hengty/DAQ_prototype/IMG_20180813_171540.jpg

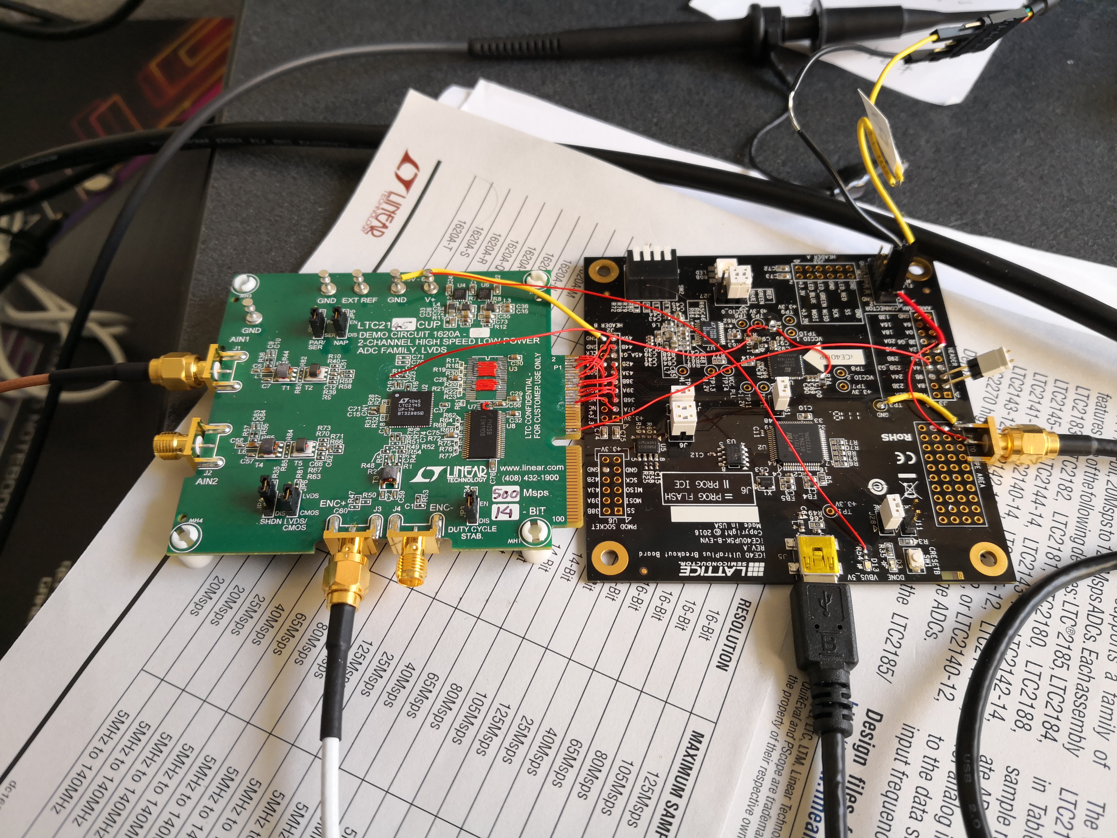
IMG_20180813_171540.jpg
