hengty/DAQ_prototype/A Demonstration of Sampling frequency Switching in the LTC2145.pdf

# A Demonstration of Sampling Frequency Switching in the LTC2145 ADC

Gen2 Hardware Meeting - Aug 16th, 2018
Bunheng Ty
ty@wisc.edu

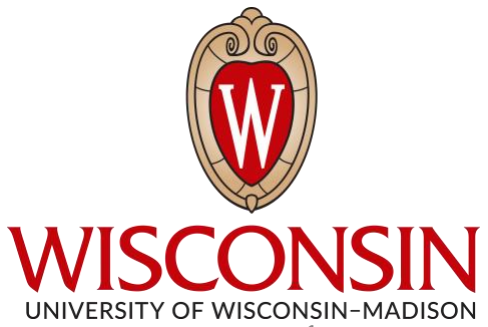
[picture p2: figure]
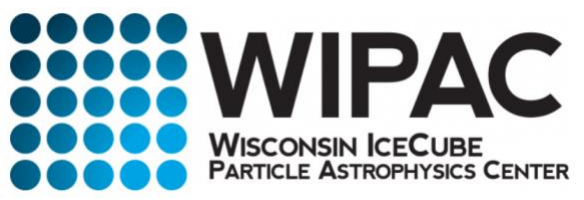
[picture p3: figure]

*official name still to be determined | 1

## Overview

- This is an update on the development of the SloDAQ*. My previous presentation was about two months ago and can be found here. (https://drive.google.com/open?id=1WATRiCVKg9uhWAbG6479csyYvLFgybAx)
- The main result here is the demonstration of sampling frequency switching in the LTC2145 ADC, between idle (10 MHz) and triggered state (120 MHz), which can save us significant power.

*official name still to be determined

## From Last Time…

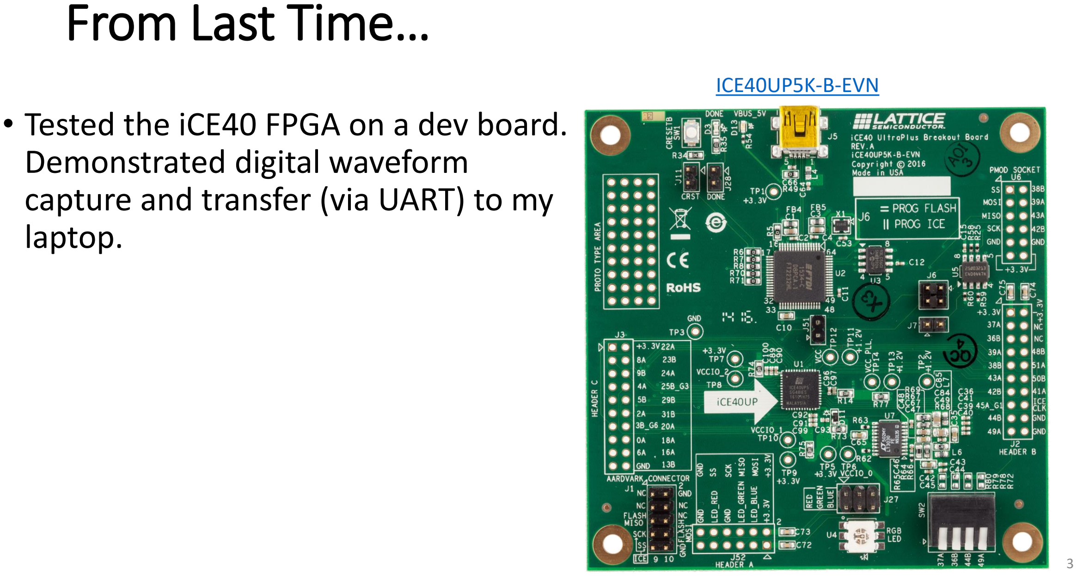
[picture p4: page 3]

ICE40UP5K-B-EVN (https://www.digikey.com/product-detail/en/lattice-semiconductor-corporation/ICE40UP5K-B-EVN/220-2134-ND/6596291)
- Tested the iCE40 FPGA on a dev board. Demonstrated digital waveform capture and transfer (via UART) to my laptop.

## From Last Time…

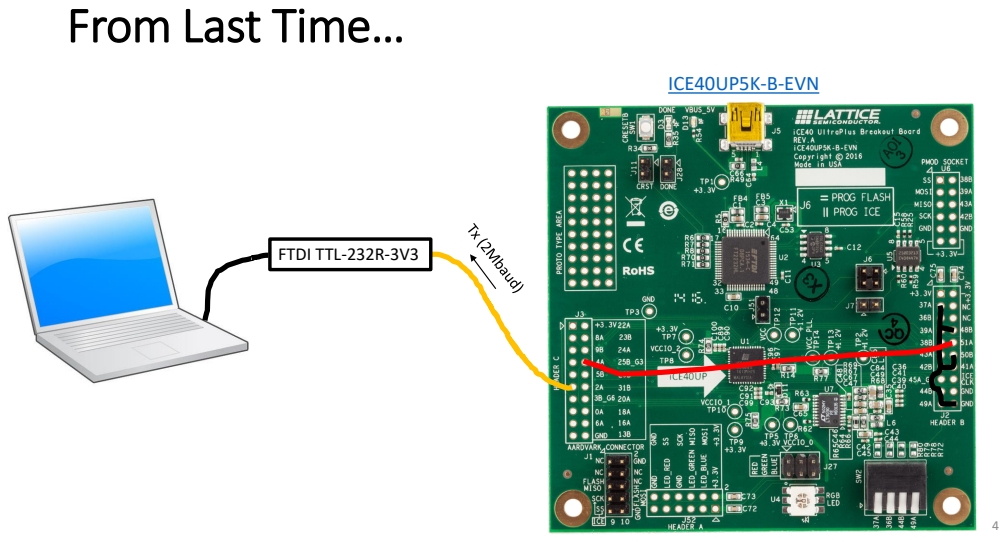
[picture p5: page 4]
ICE40UP5K-B-EVN; FTDI TTL-232R-3V3

## From Last Time…

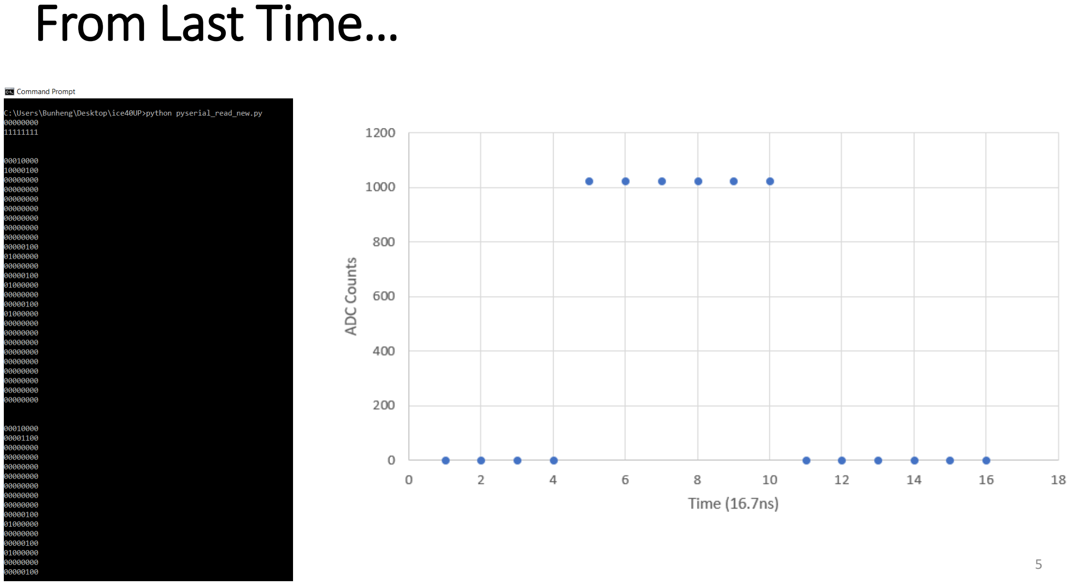
[picture p6: page 5]

## This time

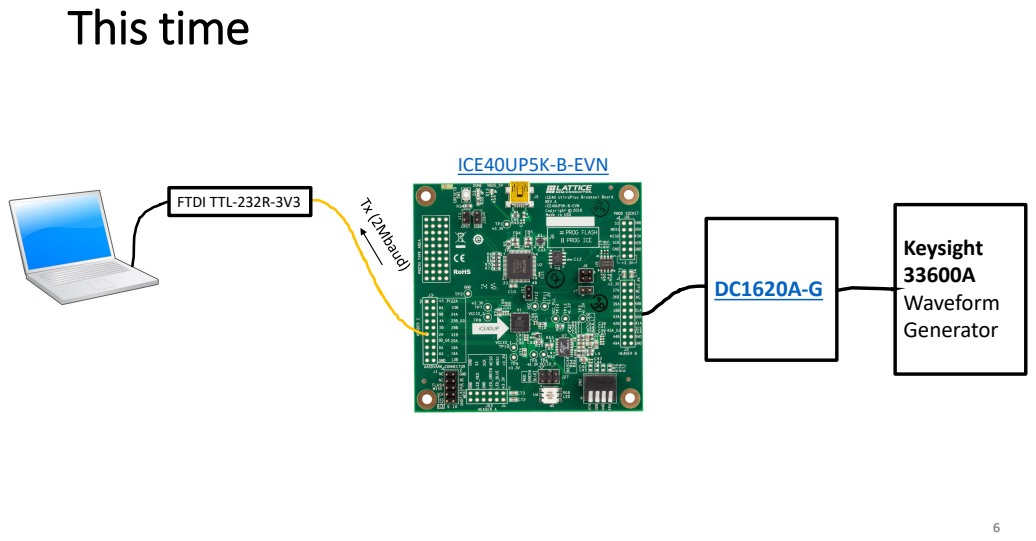
[picture p7: page 6]
ICE40UP5K-B-EVN; FTDI TTL-232R-3V3; Keysight 33600A Waveform Generator

## This time

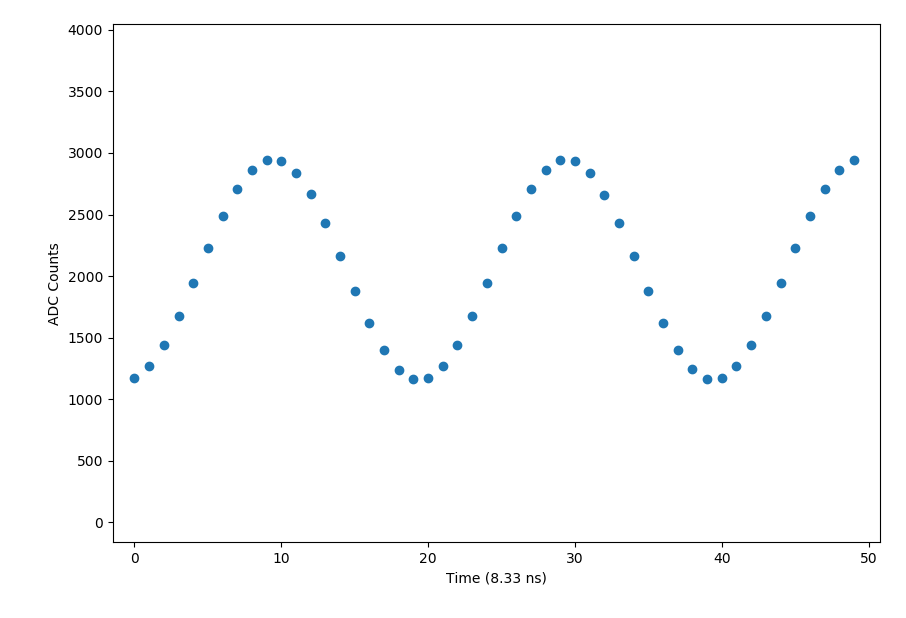
[picture p8: figure]

- 1Vpp at 6 MHz Sine wave
from the waveform
generator, digitized at
120MHz by the DC1620A
dev board, buffered and
sent to my computer by the ICE40UP5K dev board.
- Note: this is twice the
sampling frequency from
last time.

## The Main Test

- It is wasteful to digitize at full clock speed during idle periods (no signal). Can the ADC be slowed down and only digitize at full speed during a trigger?

DC1620A-G (https://www.digikey.com/product-detail/en/linear-technology-analog-devices/DC1620A-G/DC1620A-G-ND/3025200)

120 MHz

10 MHz

Triggered?

## The Main Test

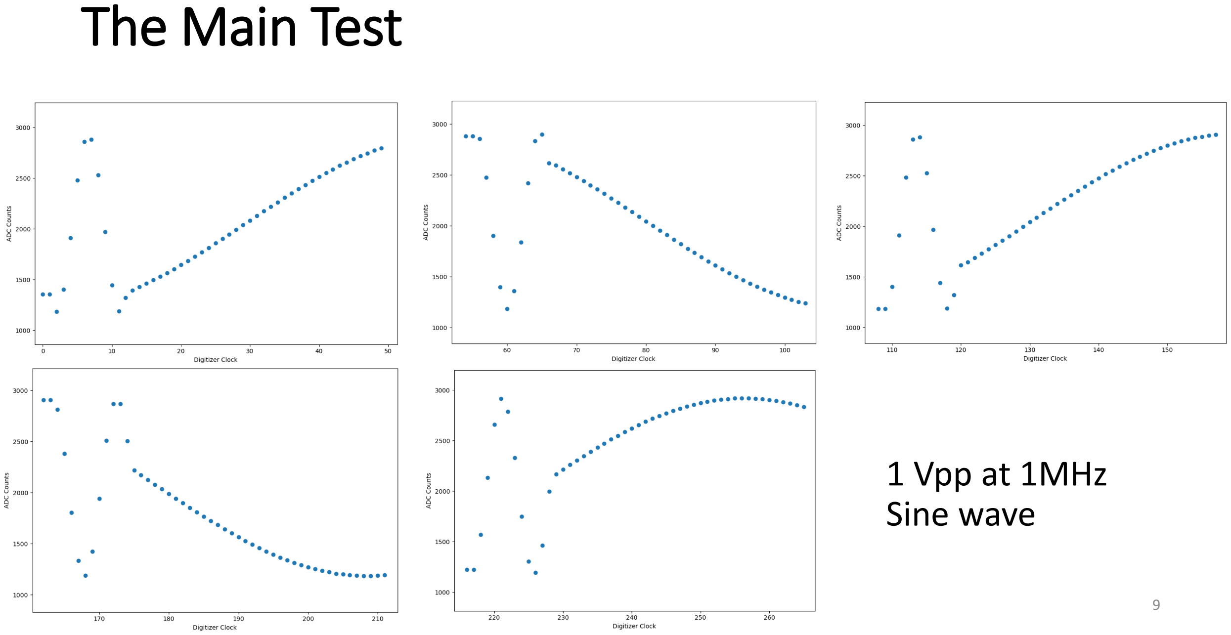
[picture p9: page 9]

1 Vpp at 1MHz
Sine wave

## The Main Test

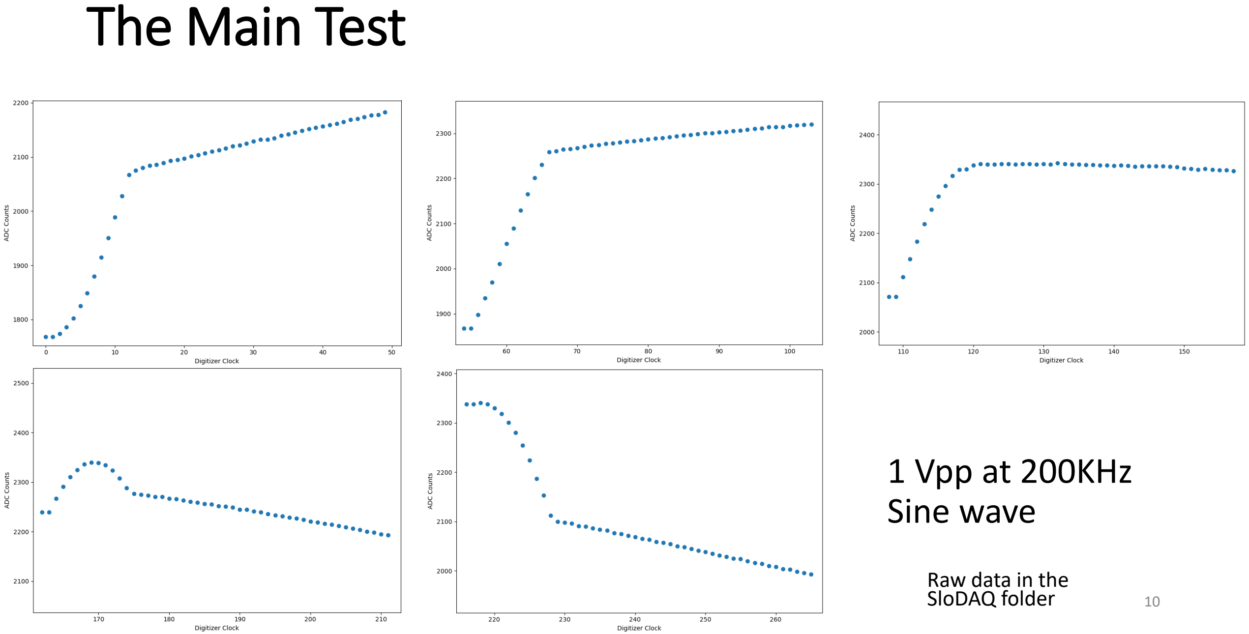
[picture p10: page 10]

1 Vpp at 200KHz
Sine wave

Raw data in the
SloDAQ folder

## Conclusions

- No quantitative statement to make at this point.
- But from the look at these waveforms, it seems like the ADC is able to handle the sudden frequency change from 10MHz to 120MHz fine.
- Mystery irregularities seen in waveforms might be due to noise in the setup, and bugs in my firmware.
- A quantitative test can be done after we route our own board. Also power measurements.
- iCE40 running at 120MHz, (What about 240?)

## Backup Slide

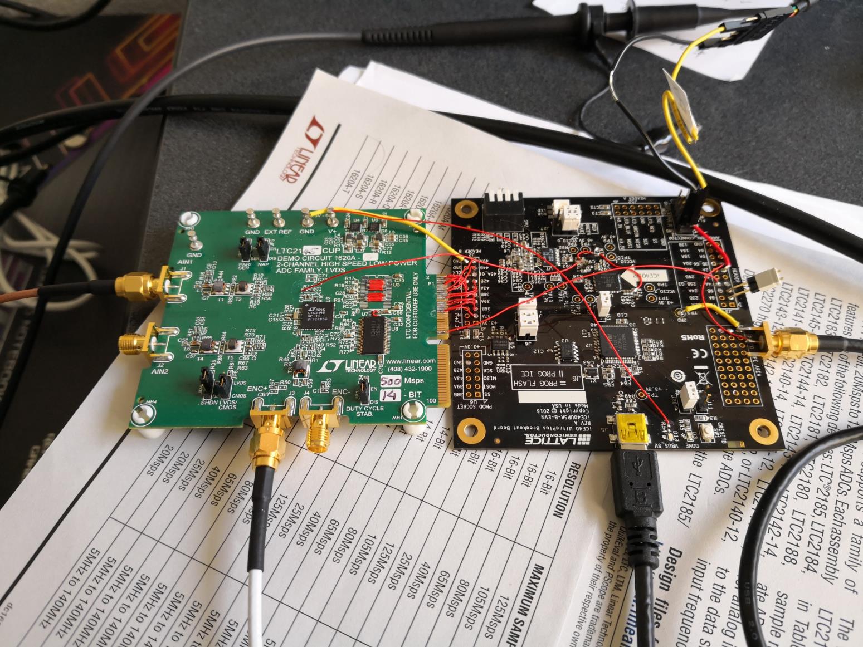
[picture p11: figure]
