hengty/DAQ_prototype/diagram.PNG

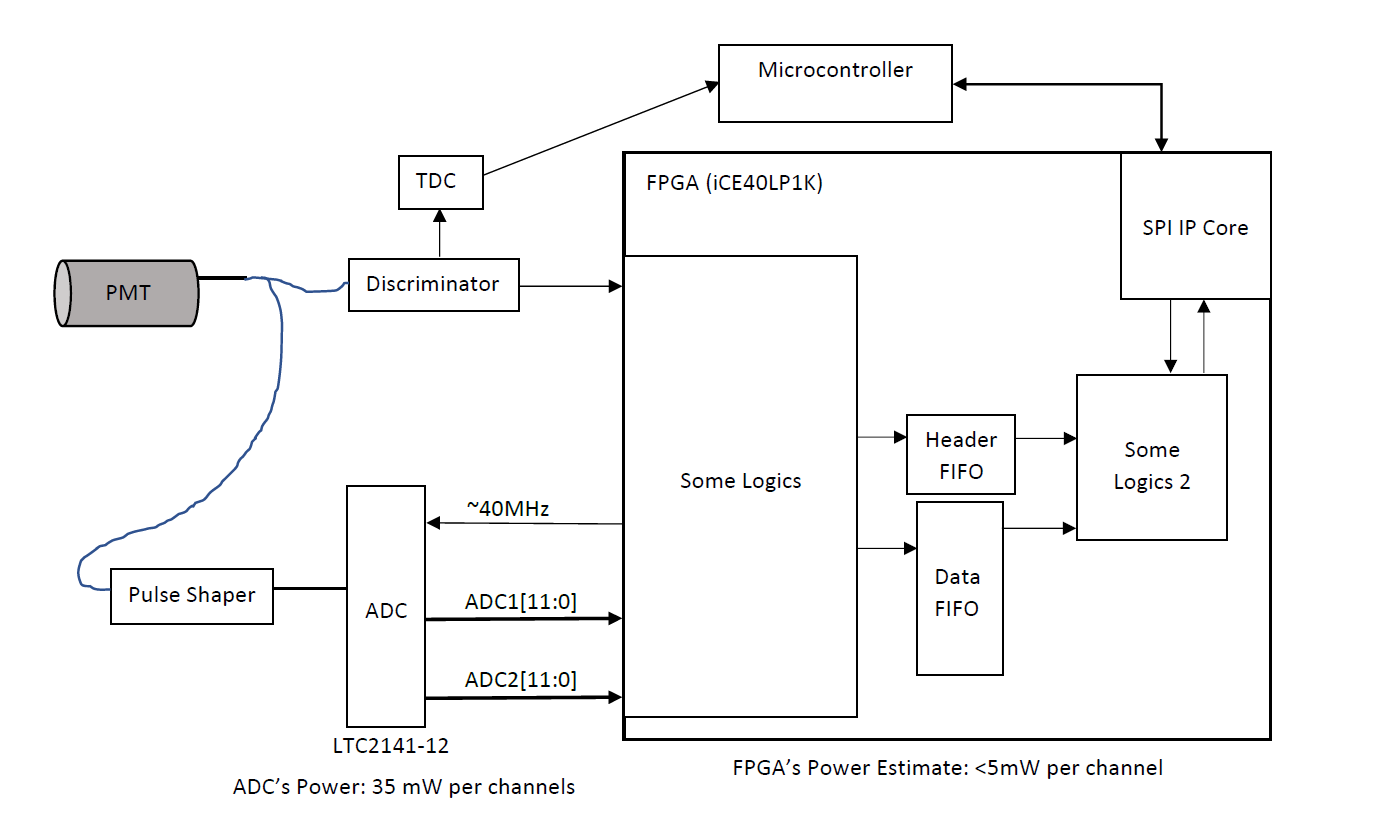
diagram.PNG
